ZeroPunchMan/cmsis-dap/circuit/dap_link.kicad_pcb

## KiCad design circuit/dap_link.kicad_pcb (2023-12-15)

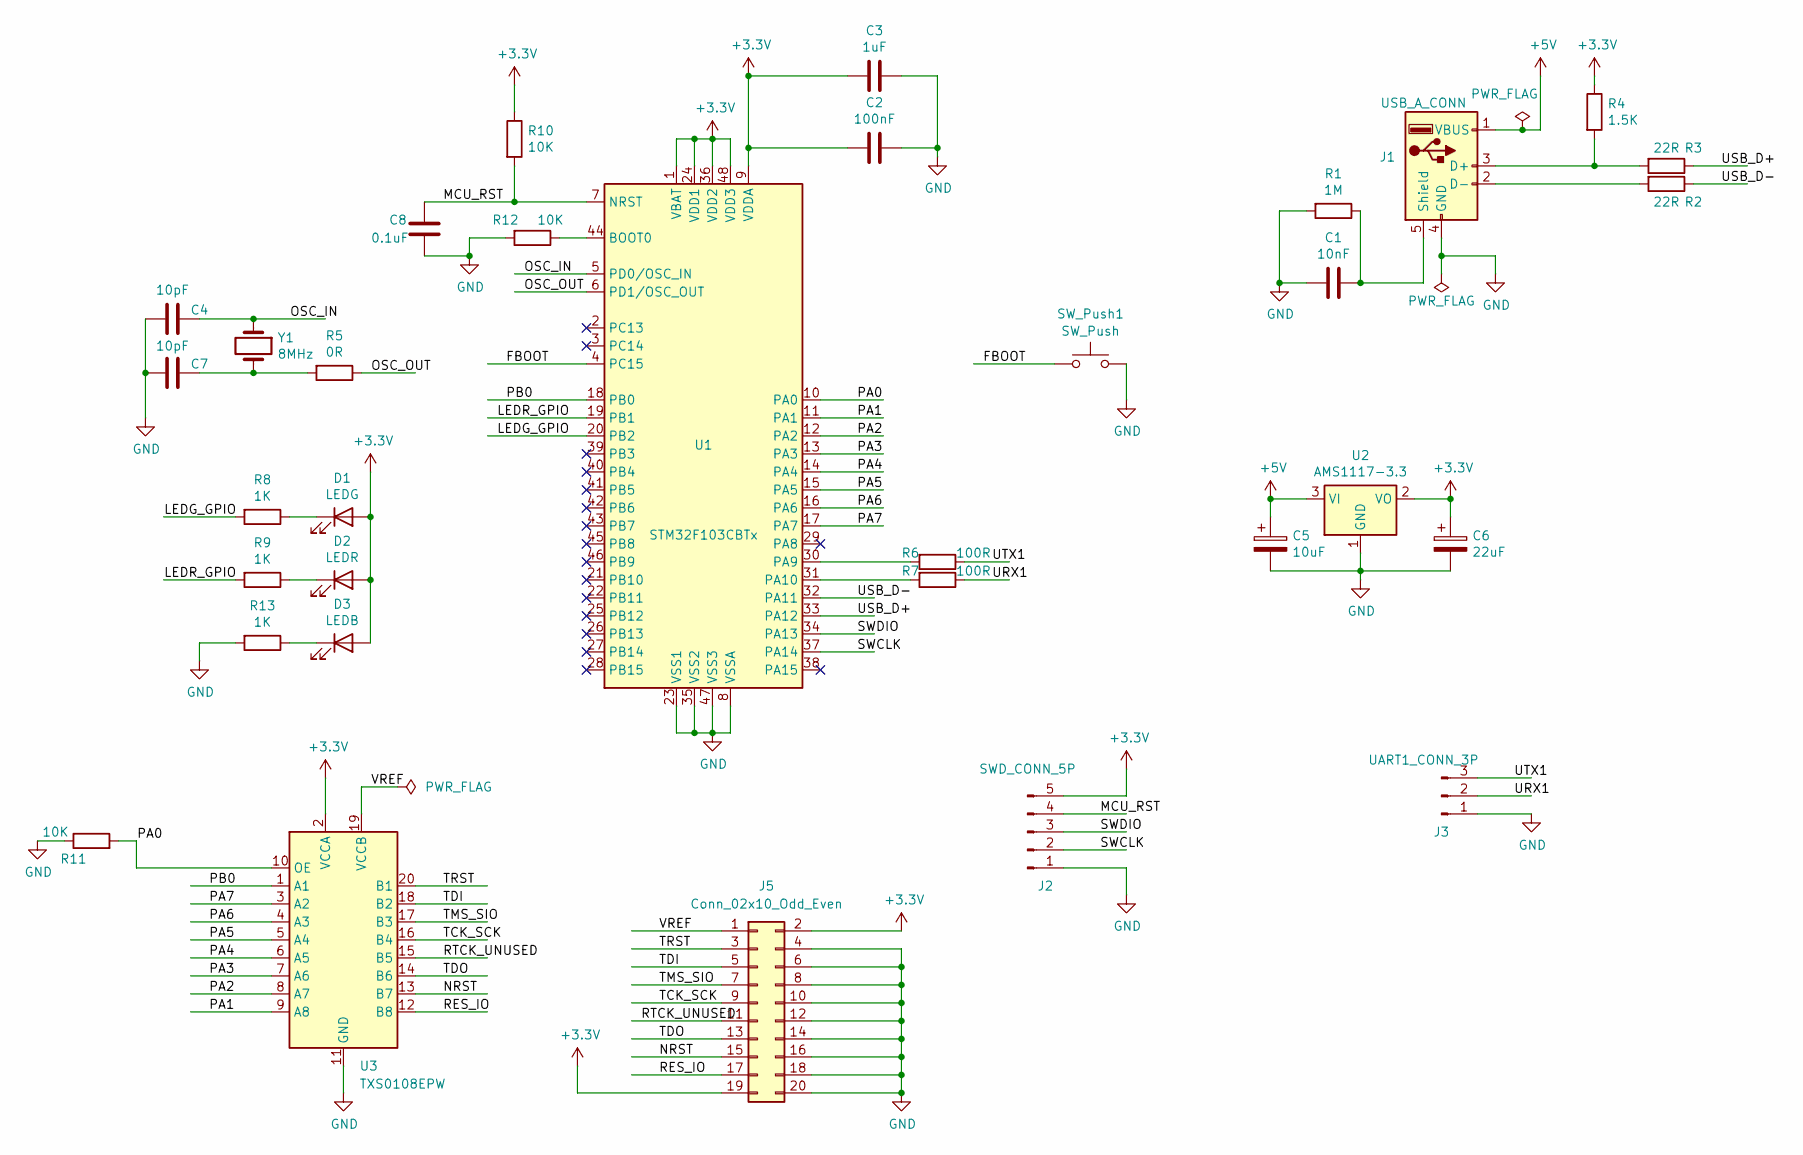
[picture p1: schematic dap_link.kicad_sch]

Parts:
C1: 10nF; C_0805_2012Metric_Pad1.18x1.45mm_HandSolder
C2: 100nF; C_0805_2012Metric_Pad1.18x1.45mm_HandSolder
C3: 1uF; C_0805_2012Metric_Pad1.18x1.45mm_HandSolder
C4, C7: 10pF; C_0805_2012Metric_Pad1.18x1.45mm_HandSolder
C5: 10uF; CP_EIA-3528-12_Kemet-T_Pad1.50x2.35mm_HandSolder
C6: 22uF; CP_EIA-3528-12_Kemet-T_Pad1.50x2.35mm_HandSolder
C8: 0.1uF; C_0805_2012Metric_Pad1.18x1.45mm_HandSolder
D1: LEDG; D_0805_2012Metric_Pad1.15x1.40mm_HandSolder
D2: LEDR; D_0805_2012Metric_Pad1.15x1.40mm_HandSolder
D3: LEDB; D_0805_2012Metric_Pad1.15x1.40mm_HandSolder
J1: USB_A_CONN; USB_A_CNCTech_1001-011-01101_Horizontal
J2: SWD_CONN_5P; PinHeader_1x05_P2.54mm_Vertical
J3: UART1_CONN_3P; PinHeader_1x03_P2.54mm_Vertical
J5: Conn_02x10_Odd_Even; PinSocket_2x10_P2.54mm_Vertical
R1: 1M; R_0805_2012Metric_Pad1.20x1.40mm_HandSolder
R2, R3: 22R; R_0805_2012Metric_Pad1.20x1.40mm_HandSolder
R4: 1.5K; R_0805_2012Metric_Pad1.20x1.40mm_HandSolder
R5: 0R; R_0805_2012Metric_Pad1.20x1.40mm_HandSolder
R6, R7: 100R; R_0805_2012Metric_Pad1.20x1.40mm_HandSolder
R8, R9, R13: 1K; R_0805_2012Metric_Pad1.20x1.40mm_HandSolder
R10, R11, R12: 10K; R_0805_2012Metric_Pad1.20x1.40mm_HandSolder
SW_Push1: SW_Push; SW_Push_1P1T_NO_6x6mm_H9.5mm
U1: STM32F103CBTx; LQFP-48_7x7mm_P0.5mm
U2: AMS1117-3.3; SOT-223-3_TabPin2
U3: TXS0108EPW; TSSOP-20_4.4x6.5mm_P0.65mm
Y1: 8MHz; Crystal_SMD_5032-2Pin_5.0x3.2mm_HandSoldering

Connections:
+3V3: C2.2, C3.2, C6.1, D1.2 (A), D2.2 (A), D3.2 (A), J2.5, J5.2, J5.19, R4.1, R10.1, U1.1 (VBAT), U1.9 (VDDA), U1.24 (VDD1), U1.36 (VDD2), U1.48 (VDD3), U2.2 (VO), U3.2 (VCCA)
+5V: C5.1, J1.1 (VBUS), U2.3 (VI)
/FBOOT: U1.4 (PC15); also elsewhere on the board
/LEDG_GPIO: R8.2, U1.20 (PB2)
/LEDR_GPIO: R9.2, U1.19 (PB1)
/MCU_RST: C8.1, J2.4, R10.2, U1.7 (NRST)
/NRST: J5.15, U3.13 (B7)
/OSC_IN: C4.1, U1.5 (PD0/OSC_IN), Y1.1
/OSC_OUT: R5.1, U1.6 (PD1/OSC_OUT)
/PA0: R11.2, U1.10 (PA0), U3.10 (OE)
/PA1: U1.11 (PA1), U3.9 (A8)
/PA2: U1.12 (PA2), U3.8 (A7)
/PA3: U1.13 (PA3), U3.7 (A6)
/PA4: U1.14 (PA4), U3.6 (A5)
/PA5: U1.15 (PA5), U3.5 (A4)
/PA6: U1.16 (PA6), U3.4 (A3)
/PA7: U1.17 (PA7), U3.3 (A2)
/PB0: U1.18 (PB0), U3.1 (A1)
/RES_IO: J5.17, U3.12 (B8)
/RTCK_UNUSED: J5.11, U3.15 (B5)
/SWCLK: J2.2, U1.37 (PA14)
/SWDIO: J2.3, U1.34 (PA13)
/TCK_SCK: J5.9, U3.16 (B4)
/TDI: J5.5, U3.18 (B2)
/TDO: J5.13, U3.14 (B6)
/TMS_SIO: J5.7, U3.17 (B3)
/TRST: J5.3, U3.20 (B1)
/URX1: J3.2, R7.1
/USB_D+: R3.1, U1.33 (PA12)
/USB_D-: R2.1, U1.32 (PA11)
/UTX1: J3.3, R6.1
/VREF: J5.1, U3.19 (VCCB)
GND: C1.2, C2.1, C3.1, C4.2, C5.2, C6.2, C7.2, C8.2, J1.4 (GND), J2.1, J3.1, J5.4, J5.6, J5.8, J5.10, J5.12, J5.14, J5.16, J5.18, J5.20, R1.2, R11.1, R12.2, R13.2, U1.8 (VSSA), U1.23 (VSS1), U1.35 (VSS2), U1.47 (VSS3), U2.1 (GND), U3.11 (GND); also elsewhere on the board
unnamed: C7.1, R5.2, Y1.2
unnamed: D1.1 (K), R8.1
unnamed: D2.1 (K), R9.1
unnamed: D3.1 (K), R13.1
unnamed: J1.3 (D+), R3.2, R4.2
unnamed: J1.2 (D-), R2.2
unnamed: C1.1, J1.5 (Shield), R1.1
unnamed: R12.1, U1.44 (BOOT0)
unnamed: R6.2, U1.30 (PA9)
unnamed: R7.2, U1.31 (PA10)

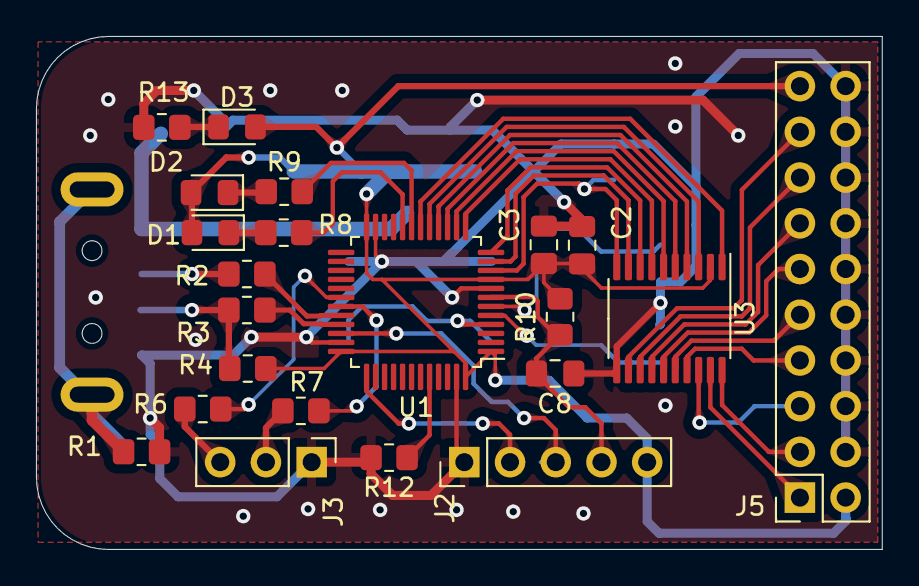
[picture p2: board dap_link.kicad_pcb from above]

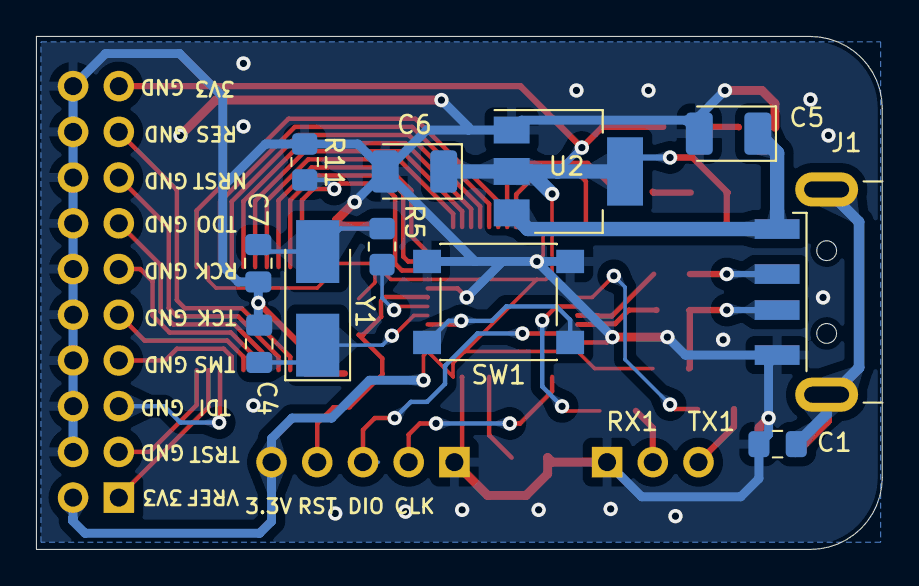
[picture p3: board dap_link.kicad_pcb from below]

Board: 2 copper layers, 47.0 x 28.5 mm, 33 parts (11 on the bottom side), 43 nets.

Other parts of the board:
SW1: SW_Push; SW_Push_1P1T_NO_6x6mm_H9.5mm

Their connections:
/FBOOT: SW1.1; also elsewhere on the board
GND: SW1.2; also elsewhere on the board
