ZeroPunchMan/cmsis-dap/firmware/Src/main.c

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
/* Includes ------------------------------------------------------------------*/
#include "main.h"
#include "usart.h"
#include "usb_device.h"
#include "gpio.h"

/* USER CODE BEGIN Includes */
#include "dap_agent.h"
#include "systime.h"
#include "my_log.h"
/* USER CODE END Includes */


void SystemClock_Config(void);
/* USER CODE BEGIN 0 */
static void UsbFakePlug(void)
{
  LL_APB2_GRP1_EnableClock(LL_APB2_GRP1_PERIPH_GPIOA);
  LL_GPIO_ResetOutputPin(GPIOA, LL_GPIO_PIN_12);

  LL_GPIO_InitTypeDef GPIO_InitStruct = {0};
  GPIO_InitStruct.Pin = LL_GPIO_PIN_12;
  GPIO_InitStruct.Mode = LL_GPIO_MODE_OUTPUT;
  GPIO_InitStruct.Speed = LL_GPIO_SPEED_FREQ_LOW;
  GPIO_InitStruct.OutputType = LL_GPIO_OUTPUT_OPENDRAIN;
  GPIO_InitStruct.Pull = LL_GPIO_PULL_UP;
  LL_GPIO_Init(GPIOA, &GPIO_InitStruct);

  LL_GPIO_ResetOutputPin(GPIOA, LL_GPIO_PIN_12);
  HAL_Delay(100);
  LL_GPIO_SetOutputPin(GPIOA, LL_GPIO_PIN_12);
}
/* USER CODE END 0 */

/**
  * @brief  The application entry point.
  * @retval int
  */
int main(void)
{
  /* MCU Configuration--------------------------------------------------------*/

  /* Reset of all peripherals, Initializes the Flash interface and the Systick. */
  HAL_Init();

  /* Configure the system clock */
  SystemClock_Config();

  /* USER CODE BEGIN SysInit */
  LL_SYSTICK_EnableIT();
  UsbFakePlug();
  /* USER CODE END SysInit */

  /* Initialize all configured peripherals */
  MX_GPIO_Init();
  MX_USART1_UART_Init();
  MX_USB_DEVICE_Init();
  /* USER CODE BEGIN 2 */
  LL_USART_EnableIT_RXNE(USART1);
  /* USER CODE END 2 */

  /* Infinite loop */
  /* USER CODE BEGIN WHILE */
  DapAgent_Init();
  // CL_LOG_INFO("init done");
  while (1)
  {
    /* USER CODE END WHILE */

    /* USER CODE BEGIN 3 */
    // static bool ledOn = false;
    static uint32_t lastTime = 0;
    if (SysTimeSpan(lastTime) >= SYSTIME_SECOND(1))
    {
      lastTime = GetSysTime();
      // CL_LOG_INFO("%lds", lastTime / 1000);
      // DapAgent_Test();

      // ledOn = !ledOn;
      // if (ledOn)
      //   LL_GPIO_ResetOutputPin(GPIOA, LL_GPIO_PIN_8);
      // else
      //   LL_GPIO_SetOutputPin(GPIOA, LL_GPIO_PIN_8);
    }
    DapAgent_Process();
  }
  /* USER CODE END 3 */
}

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
