ZeroPunchMan/cmsis-dap/(commit log)

2023-03-30 usb reset need test
    [board_cfg.h]
2023-12-07 宏增加括号
2023-12-11 增加IO口注释
2023-12-11 新版kicad
    [dap_link.kicad_pcb, dap_link.kicad_sch]
2023-12-11 移除旧版kicad文件
    [dap_link.sch]
2023-12-11 kicad有DRC错误
    [dap_link.kicad_pcb, dap_link.kicad_sch]
2023-12-11 DRC通过
    [dap_link.kicad_pcb]
2023-12-11 添加泪滴
    [dap_link.kicad_pcb]
2023-12-11 修改IO配置
2023-12-11 更新clib
2023-12-14 板子加OE下拉 IO初始化修改
    [dap_link.kicad_pcb, dap_link.kicad_sch]
2023-12-14 增加电源指示灯
    [dap_link.kicad_pcb, dap_link.kicad_sch]
2023-12-14 nrst改为推挽输出
2023-12-14 USB座子边距
    [dap_link.kicad_pcb]
2023-12-14 增加圆边
    [dap_link.kicad_pcb]
2023-12-14 接口增加一个3.3V
    [dap_link.kicad_pcb, dap_link.kicad_sch]
2023-12-14 增加丝印,缩小USB边距
    [dap_link.kicad_pcb]
2023-12-15 增加boot按钮
    [dap_link.kicad_pcb, dap_link.kicad_sch]
2023-12-15 更新丝印
    [dap_link.kicad_pcb, dap_link.kicad_sch]
